PaulZC/Iridium_9603_Beacon_Prototype/Iridium_9603_Beacon_Prototype.pdf

## Iridium 9603 Beacon Prototype Paul Clark 03/09/16

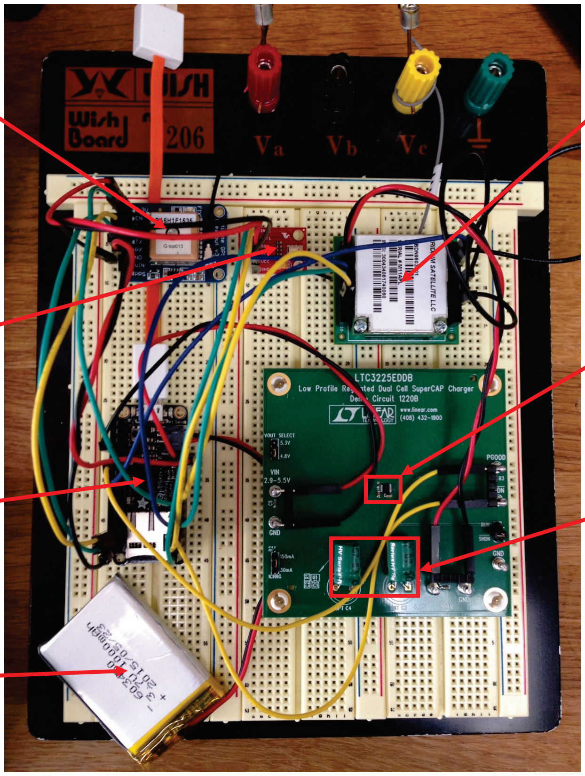
[picture p1: figure]

Adafruit Ultimate GPS Breakout https://www.adafruit.com/products/746 (GlobalTop FGPMMOPA6H)

Sparkfun MPL3115A2 Breakout
(Pressure and Temperature) https://www.sparkfun.com/products/11084

Adafruit Feather Adalogger M0 https://www.adafruit.com/products/2796

3.7V 1000mAh LiPo
(For testing only – no good for flight!
To be replaced with 3 x Energiser Ultimate Lithium AAA Cells)

2 x 1F 2.7V SuperCapacitors Bussmann HV0810-2R7105-R

Linear Technology LTC3225
SuperCapacitor Charger
http://www.linear.com/product/LTC 3225 (http://www.linear.com/product/LTC3225)
http://www.linear.com/solutions/2 187 (http://www.linear.com/solutions/2187)

Iridium 9603 on Satelligent DIP Adapter
https://www.iridium.com/products/details/iridium-9603 (https://www.iridium.com/products/details/iridium-9603)
http://satelligent.ca/products/accessories/9603-dip/ (http://satelligent.ca/products/accessories/9603-dip/)

Not Shown:
External Iridium Antenna
(To be replaced with Taoglas IP.1621.25.4.A.02)
