PaulZC/Iridium_9603_Beacon_Prototype/Iridium_9603_Beacon_Prototype_Fritzing.pdf

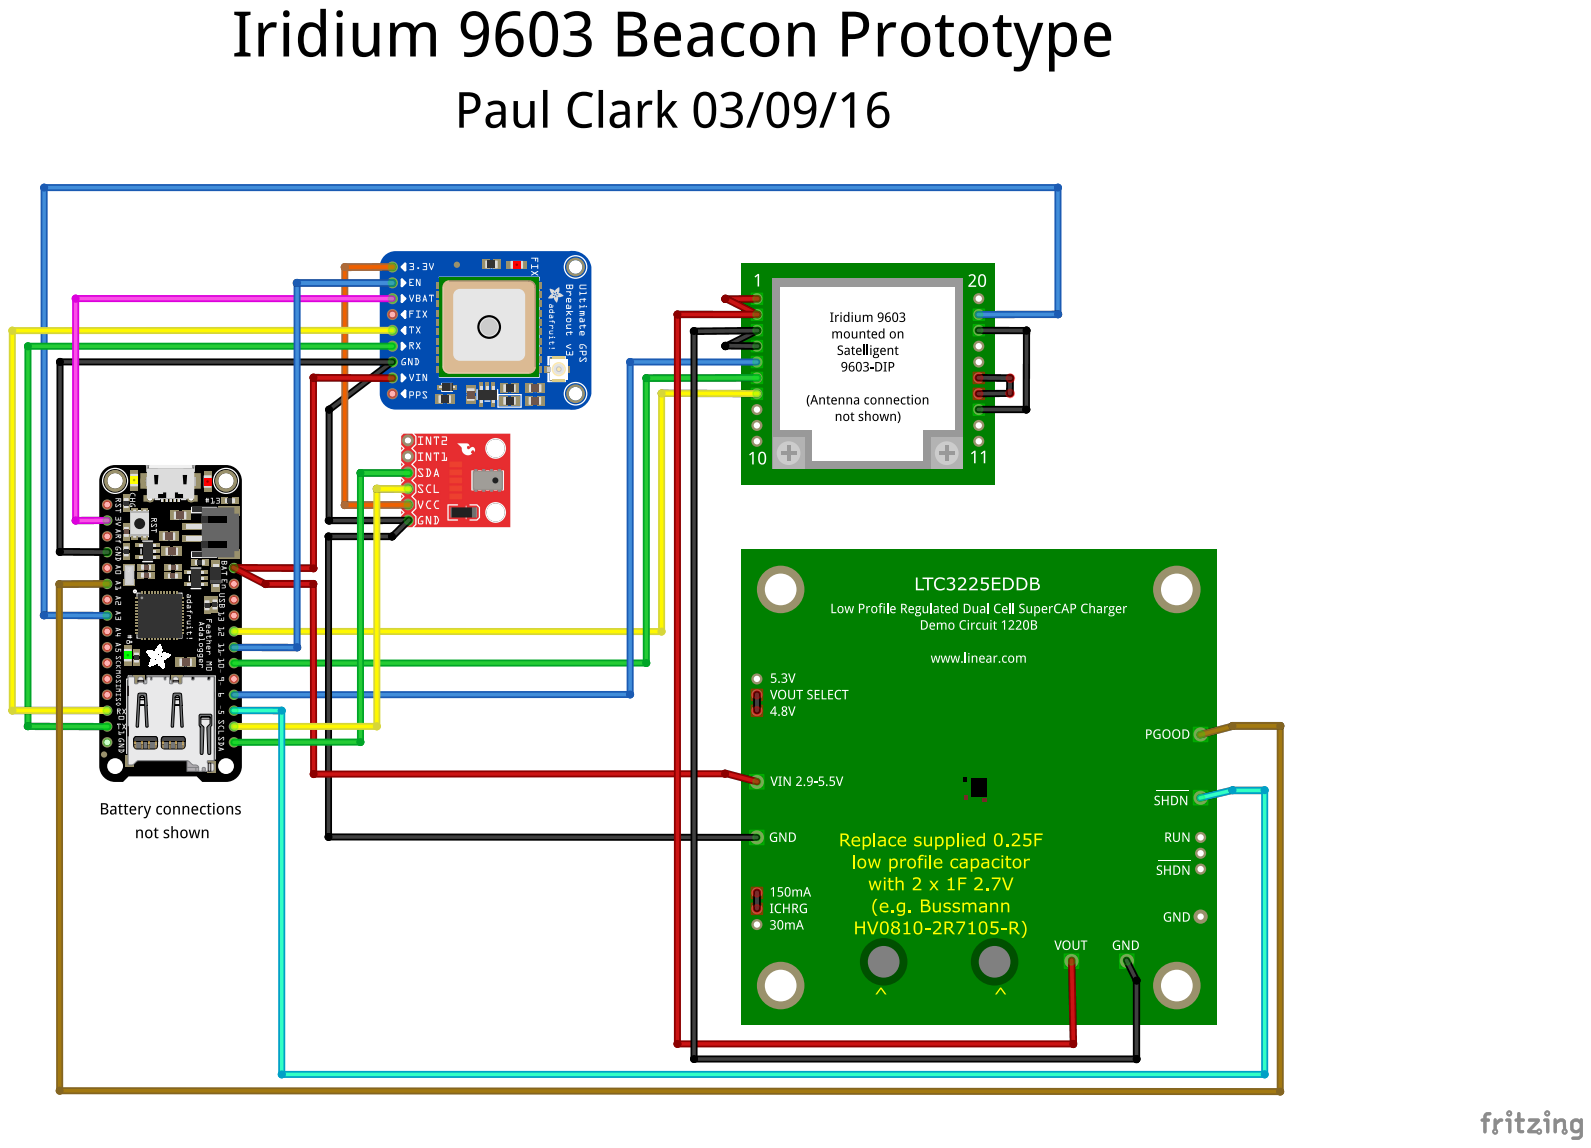
[picture p2: page 1]
