PaulZC/Iridium_9603_Beacon_Prototype/Iridium_9603_Beacon_Prototype_Battery_Test.png

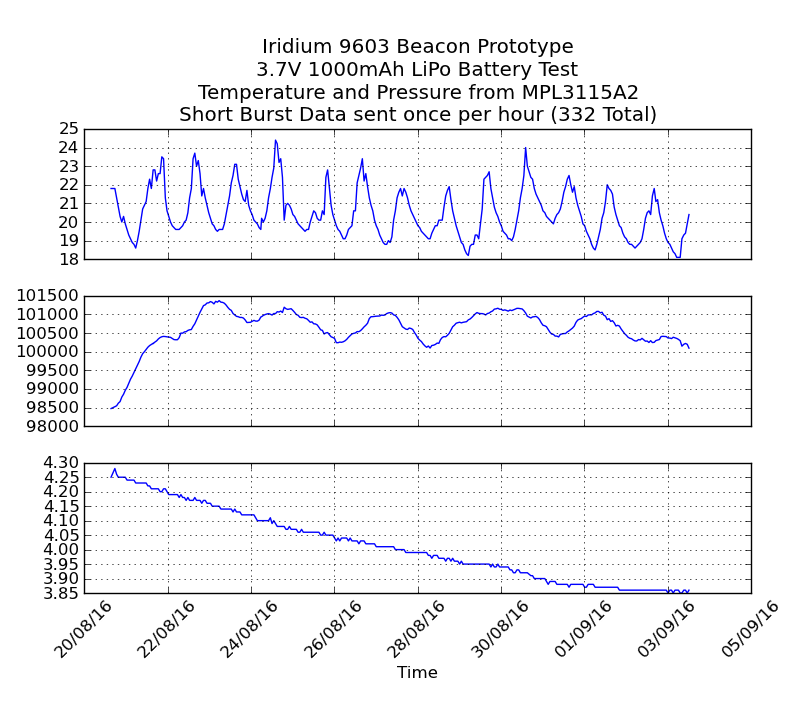
Iridium_9603_Beacon_Prototype_Battery_Test.png
