PaulZC/Iridium_9603_Beacon_Prototype/(commit log)

2016-09-04 First release
    Details of a prototype Iridium 9603 beacon/tracker which should - with a
    dedicated PCB - weigh in at ~70g
2016-09-04 Bug fix
    Updated alarmMatch to correct an error in the hour roll-over. Much
    better now...
    [IridiumSBDBeacon.ino]
2016-09-07 Added support for the Ultimate GPS FeatherWing
    Added support for the Ultimate GPS FeatherWing (GPS_EN is inverted)
    [IridiumSBDBeacon.ino]
2017-07-06 Changed the name of the Arduino file to avoid confusion with Iridium9603Beacon
    [IridiumSBDBeaconPrototype.ino]
